sirJolo/ascom-jolo-focuser/Docs/monitor1.jpg

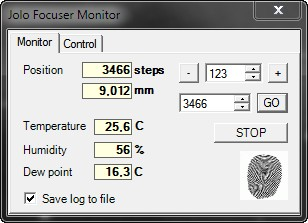
Docs/monitor1.jpg
