sirJolo/ascom-jolo-focuser/Docs/monitor2.jpg

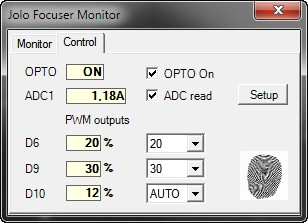
Docs/monitor2.jpg
