sirJolo/ascom-jolo-focuser/Eagle/pcb.jpg

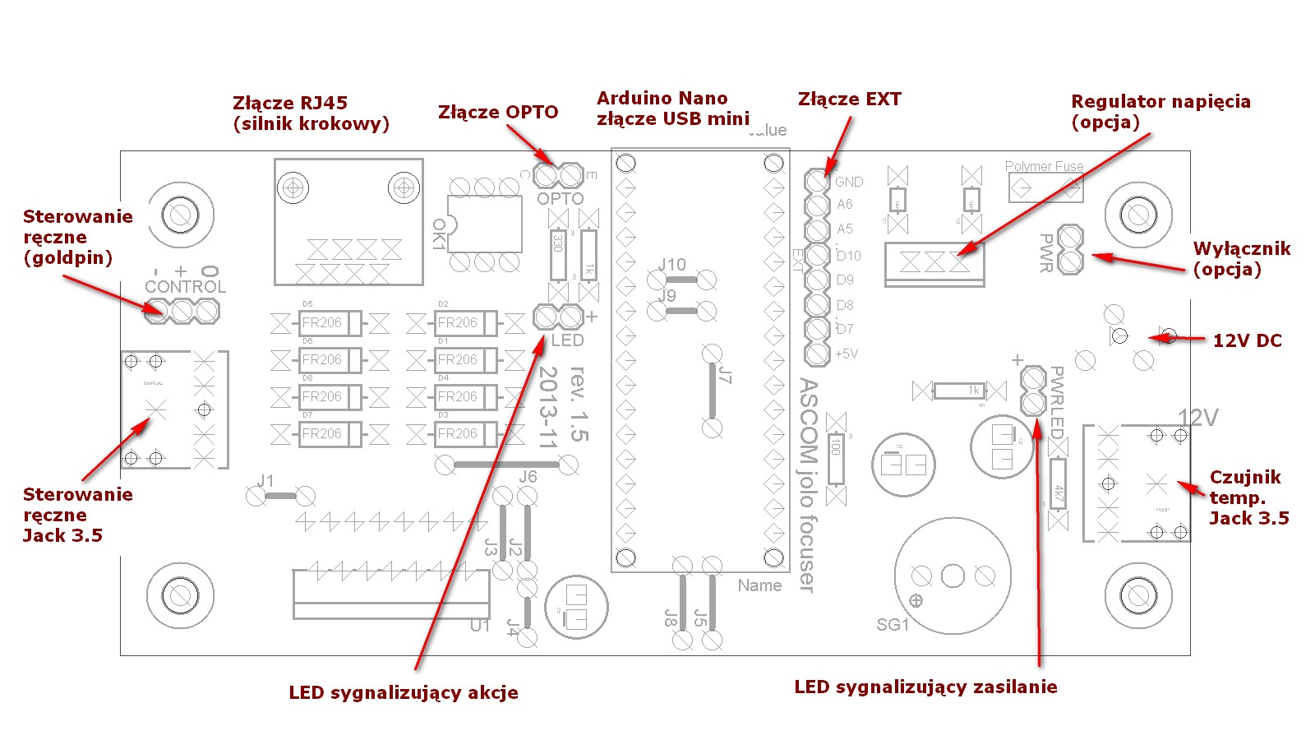
Eagle/pcb.jpg
