sirJolo/ascom-jolo-focuser/Eagle/schematic.jpg

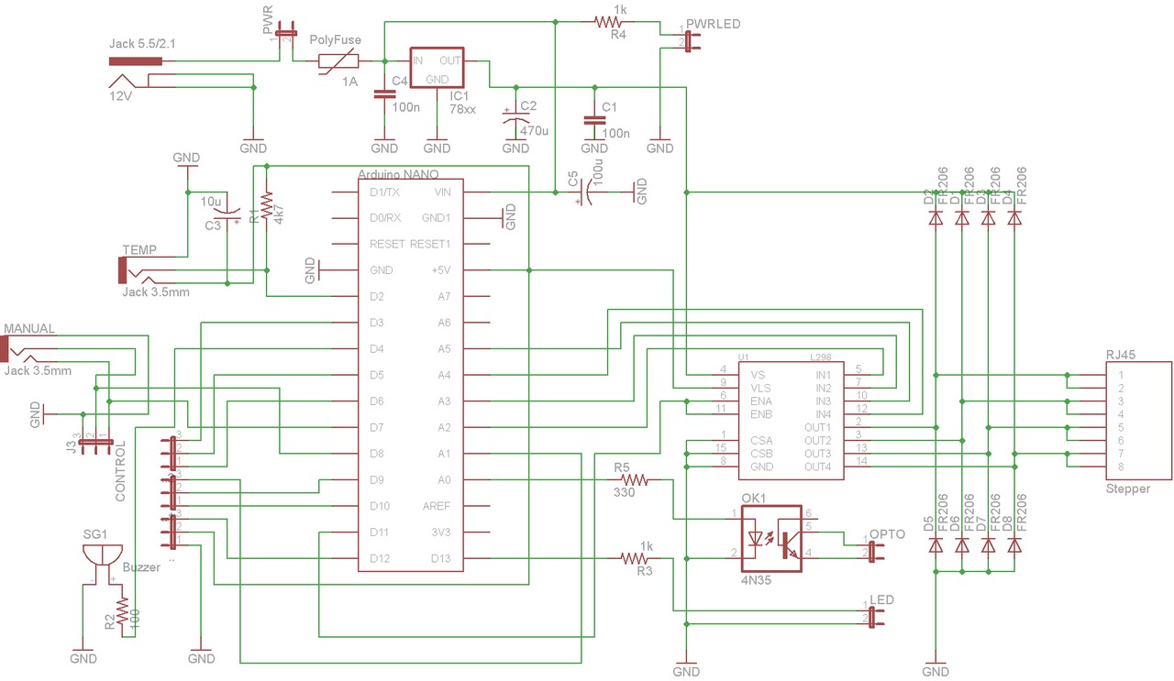
Eagle/schematic.jpg
