sirJolo/ascom-jolo-focuser/Eagle/focuser-no-jumper.brd

## EAGLE design Eagle/focuser-no-jumper.brd (2014-06-11)

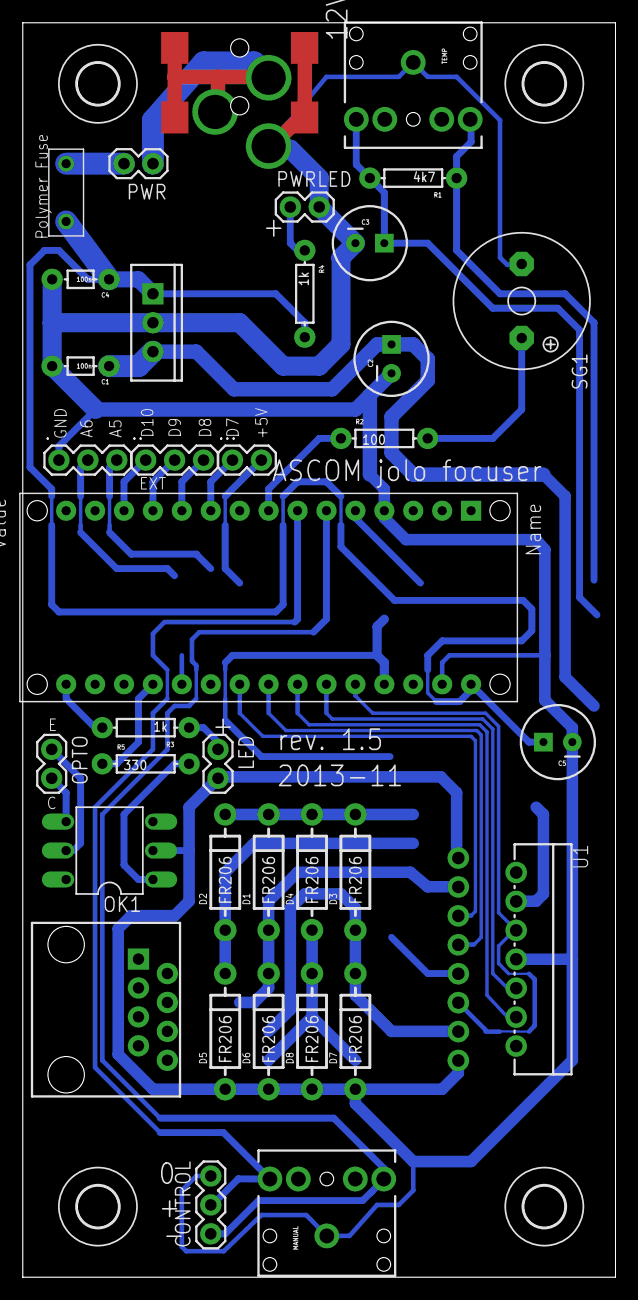
[picture p43: board focuser-no-jumper.brd from above]

Board: 2 copper layers, 52.0 x 110.2 mm, 40 parts (0 on the bottom side), 33 nets.

Parts:
0.9A: PolyFuse; PTC
12V: Jack 5.5/2.1; POWER_JACK_COMBO
., ..: 1X03
...: 1X02
C1, C4: 100n; AXIAL-5MM
C2: 470u; CPOL-RADIAL-100UF-25V
C3: 10u; CPOL-RADIAL-100UF-25V
C5: 100u; CPOL-RADIAL-100UF-25V
CONTROL: J3; 1X03
D1, D2, D3, D4, D5, D6, D7, D8: FR206; DIODE-1N4001
IC1: 78xx; TO220-IGO
LED: 1X02
MANUAL: Jack 3.5mm; AUDIO-JACK
NANO: MMduino; PDIP-32
OK1: 4N35; DIL06
OPTO: 1X02
PWR: 1X02
PWRLED: 1X02
R1: 4k7; AXIAL-0.3
R2: 100; AXIAL-0.3
R3, R4: 1k; AXIAL-0.3
R5: 330; AXIAL-0.3
RJ45: Stepper; RJ45-8
SG1: Buzzer; F/QMBIII
TEMP: Jack 3.5mm; AUDIO-JACK
U1: L298; MULTIWATT15
U$2, U$3, U$4, U$5: 3,6

Connections:
+5: ....2, C3.1, NANO.+5V, R1.P$2, TEMP.5, U1.9
GND: 12V.POWER, ..1, C1.P$2, C2.2, C3.2, C4.P$2, C5.2, CONTROL.3, D5.A, D6.A, D7.A, D8.A, IC1.GND, LED.2, MANUAL.1, NANO.GND, NANO.GND1, OK1.2, PWRLED.2, SG1.-, TEMP.1, U1.1, U1.8, U1.15
unnamed: R2.P$2, SG1.+
unnamed: NANO.A0, U1.6, U1.11
unnamed: NANO.A4, U1.5
unnamed: NANO.A3, U1.7
unnamed: 0.9A.P$2, PWR.2
unnamed: ....1, NANO.D7
unnamed: 0.9A.P$1, C4.P$1, C5.1, IC1.IN, NANO.VIN, R4.P$2
unnamed: D4.A, D8.C, RJ45.7, RJ45.8, U1.14
unnamed: ..3, NANO.A5
unnamed: NANO.A1, U1.10
unnamed: D1.A, D6.C, RJ45.3, RJ45.4, U1.3
unnamed: NANO.A2, U1.12
unnamed: D2.A, D5.C, RJ45.1, RJ45.2, U1.2
unnamed: NANO.D2, R1.P$1, TEMP.2
unnamed: CONTROL.2, MANUAL.2, NANO.D4
unnamed: PWRLED.1, R4.P$1
unnamed: D3.A, D7.C, RJ45.5, RJ45.6, U1.13
unnamed: CONTROL.1, MANUAL.5, NANO.D3
unnamed: ..2, NANO.A6
unnamed: NANO.D13, R3.P$2
unnamed: LED.1, R3.P$1
unnamed: ...3, NANO.D8
unnamed: ...2, NANO.D9
unnamed: ...1, NANO.D10
unnamed: NANO.D5, R2.P$1
unnamed: NANO.A7, R5.P$1
unnamed: OK1.1, R5.P$2
unnamed: OK1.4, OPTO.2
unnamed: OK1.5, OPTO.1
VCC: 12V.GND@1, PWR.1
VCC2: C1.P$1, C2.1, D1.C, D2.C, D3.C, D4.C, IC1.OUT, U1.4
