sirJolo/ascom-jolo-focuser/(commit log)

2013-01-22 Initial Arduino sketch
2013-01-22 arduino sketch update
2013-01-22 Stepper init speed fix.
    [focuser.ino]
2013-01-22 Pin reconfig
2013-01-23 Driver project init commit
2013-01-23 Temperature and backslash compensation
2013-01-23 Stepper lib added (issue #2)
2013-01-23 Non blocking stepper library
2013-01-24 Driver fixes
2013-01-24 Arduino clean up
2013-01-26 Stepper refactoring
2013-01-30 Async stepper lib
2013-02-03 New stepper lib
2013-02-03 Accel stepper back, bugfixes
    [encoder.ino, focuser.ino, init.ino, serial.ino, utils.ino]
2013-02-04 Driver set focuser position
2013-02-06 Driver backslash, temp comp tested with device mock
2013-02-06 Driver installer
2013-02-08 Driver setup dialog fixes
    [focuser.ino, serial.ino]
2013-02-08 Buzz control, high freq PWM lib
    [buzzer.ino, focuser.ino, init.ino, serial.ino]
2013-11-08 ASCOM driver ver. 1.3
2013-11-08 Arduino ver. 1.3
2013-11-16 Production branch
    [focuser.brd, focuser.sch]
2013-11-16 Encoder control removed. Pin config updated.
2013-11-18 Production PCB refactor
    [focuser.brd]
2013-11-22 OPTO simple and time control
    [focuser-no-jumper.brd, focuser-no-jumper.sch]
2013-12-10 Production final refactor
    [focuser.sch]
2014-04-07 Focuser 2.0
    [focuser.brd, focuser.sch]
2014-04-08 Focuser 2.0 - PCB
    [focuser.brd, focuser.sch]
2014-05-13 Arduino / Eagle updates
    [focuser-no-jumper.sch, focuser.brd, focuser.sch]
2014-05-17 Arduino update
2014-05-17 Arduino update / doc update
2014-07-01 2.1 arduino working copy (LCD I2C DHT)
2014-07-08 2.1 arduino + ASCOM working copy
2014-07-09 2.1 arduino + ASCOM working copy + log + new communication format
2014-11-17 ASCOM driver return values caching added
2014-11-24 ASCOM driver ver. 2.2 - fixed: driver error when working from scripts due to not working sync lock
    [focuser.ino]
